Levitation-Texas-Guadaloop/Lev-Main/misc/Diagram_1.png

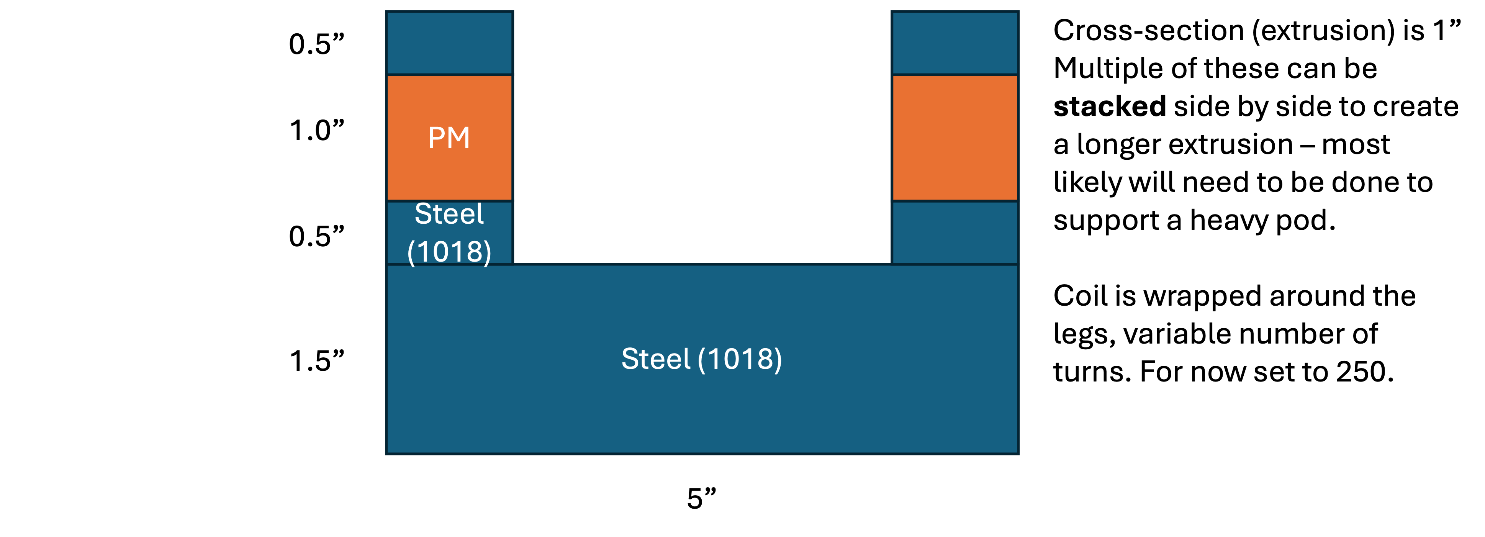
misc/Diagram_1.png
