Levitation-Texas-Guadaloop/Lev-Main/SCS_Laminations/preview.png

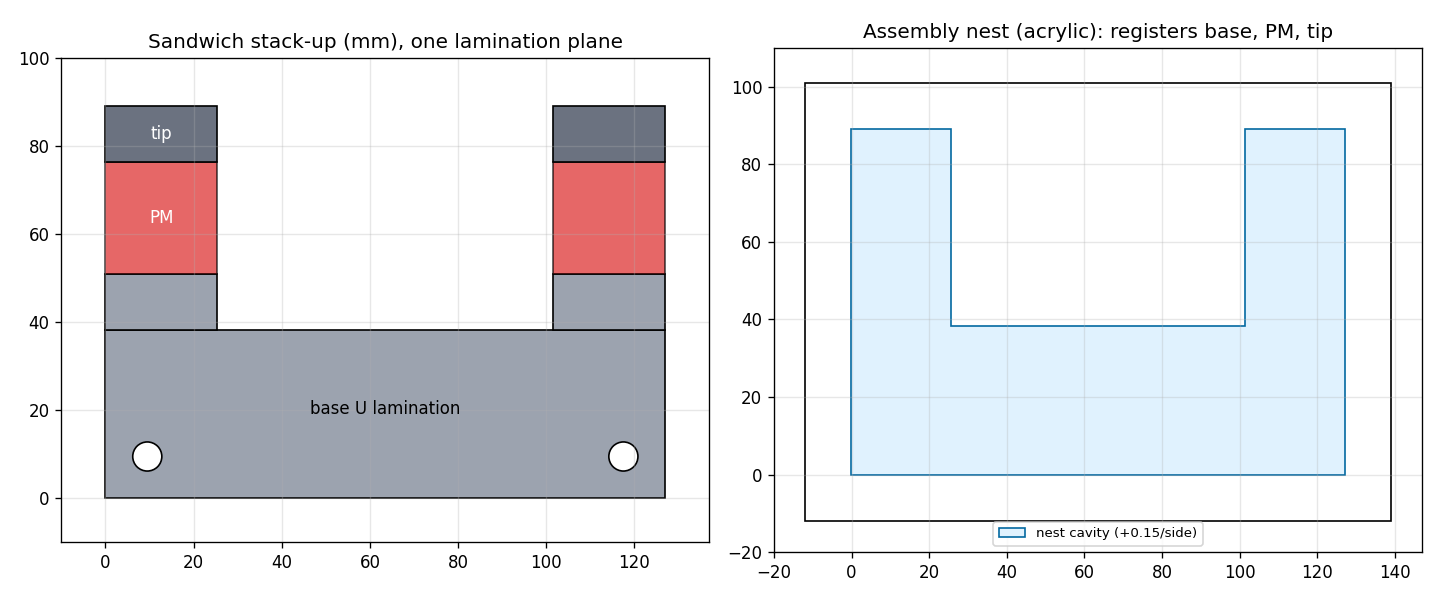
SCS_Laminations/preview.png
