Levitation-Texas-Guadaloop/Lev-Main/tutorials/bode_poles/fig1_bode_good_design.png

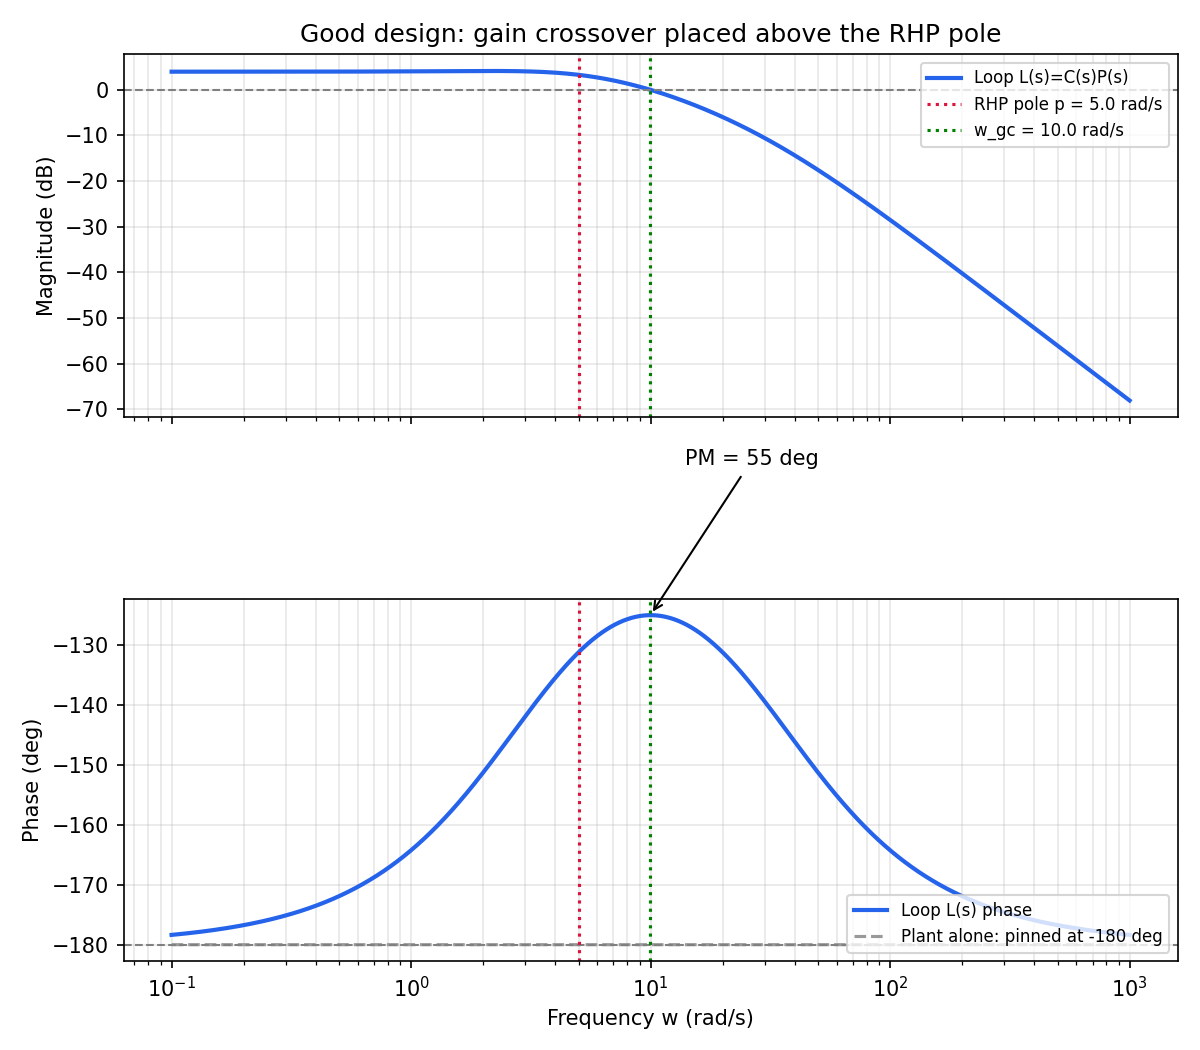
tutorials/bode_poles/fig1_bode_good_design.png
