Levitation-Texas-Guadaloop/Lev-Main/SCS_Lamination_CrossSection.FCStd

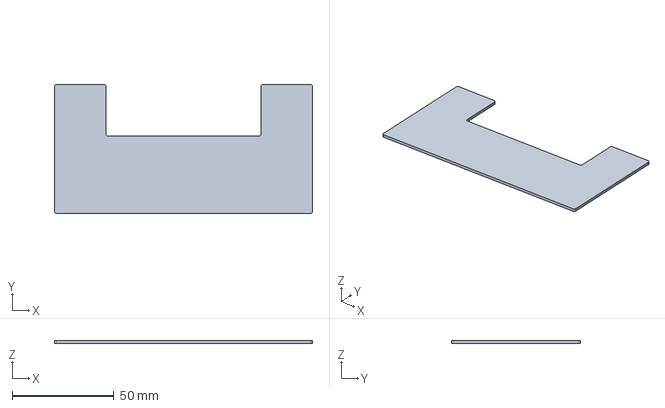
[picture p4: CAD file, 2026-09-30]
SCS_Lamination_CrossSection.FCStd
127.0 x 63.5 x 1.50 mm
