Levitation-Texas-Guadaloop/Lev-Main/SCS_Laminations/SCS_Lamination_CrossSection-Body.step

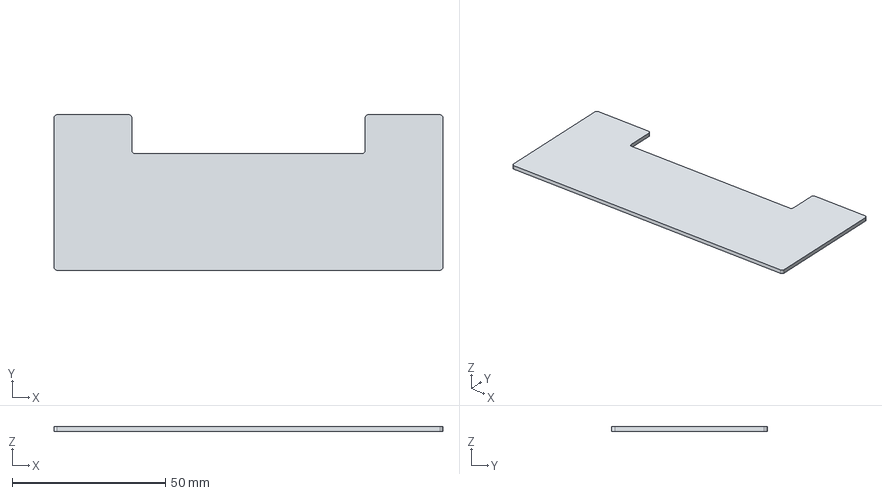
[picture p6: CAD file, 2026-10-15]
SCS_Laminations/SCS_Lamination_CrossSection-Body.step
127.0 x 50.8 x 1.50 mm
