Levitation-Texas-Guadaloop/Lev-Main/SCS_Laminations/pole_tip_lamination.dxf

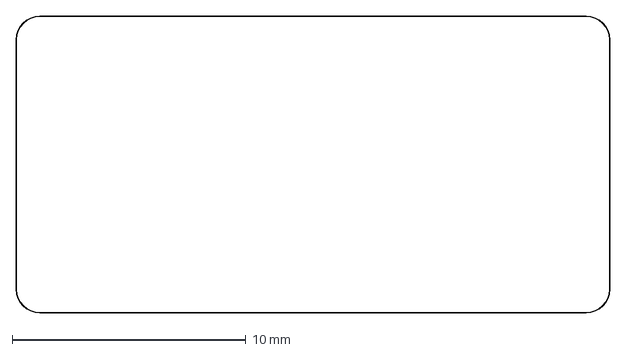
[picture p7: CAD file, 2026-10-15]
SCS_Laminations/pole_tip_lamination.dxf
25.4 x 12.7 mm
