Levitation-Texas-Guadaloop/Lev-Main/SCS_Laminations/jig_nest_bottom.dxf

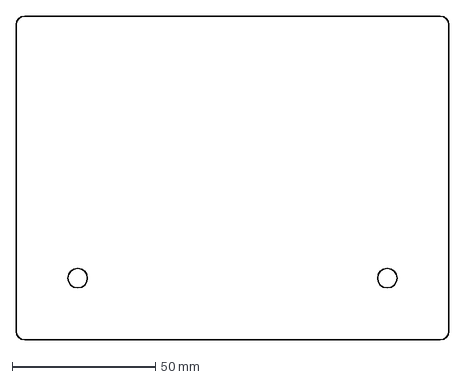
[picture p8: CAD file, 2026-10-15]
SCS_Laminations/jig_nest_bottom.dxf
151.0 x 112.9 mm
