Levitation-Texas-Guadaloop/Lev-Main/SCS_Laminations/jig_tip_bottom.dxf

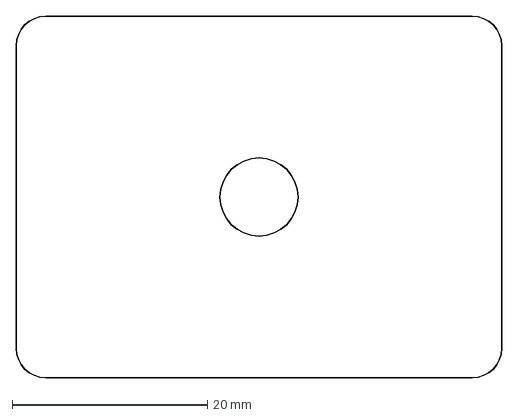
[picture p9: CAD file, 2026-10-15]
SCS_Laminations/jig_tip_bottom.dxf
49.7 x 37.0 mm
