Levitation-Texas-Guadaloop/Lev-Main/SCS_Laminations/jig_nest_cavity.dxf

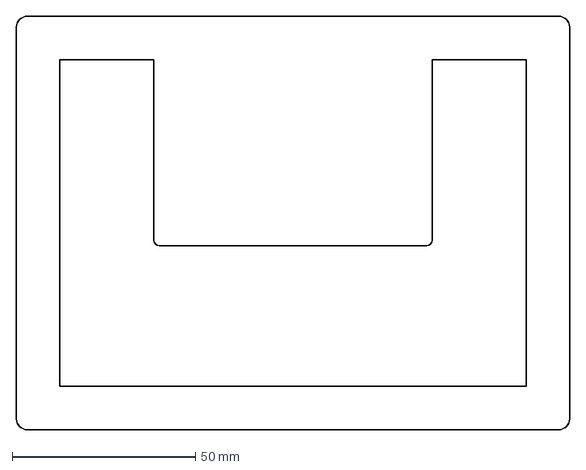
[picture p10: CAD file, 2026-10-15]
SCS_Laminations/jig_nest_cavity.dxf
151.0 x 112.9 mm
