Levitation-Texas-Guadaloop/Lev-Main/(list of files, cad)

Other CAD files:
SCS_Lamination_CrossSection_STP.step
SCS_Laminations/SCS_Lamination_CrossSection.FCStd
