Levitation-Texas-Guadaloop/Lev-Main/tutorials/bode_poles/fig0_bode_plant_only.png

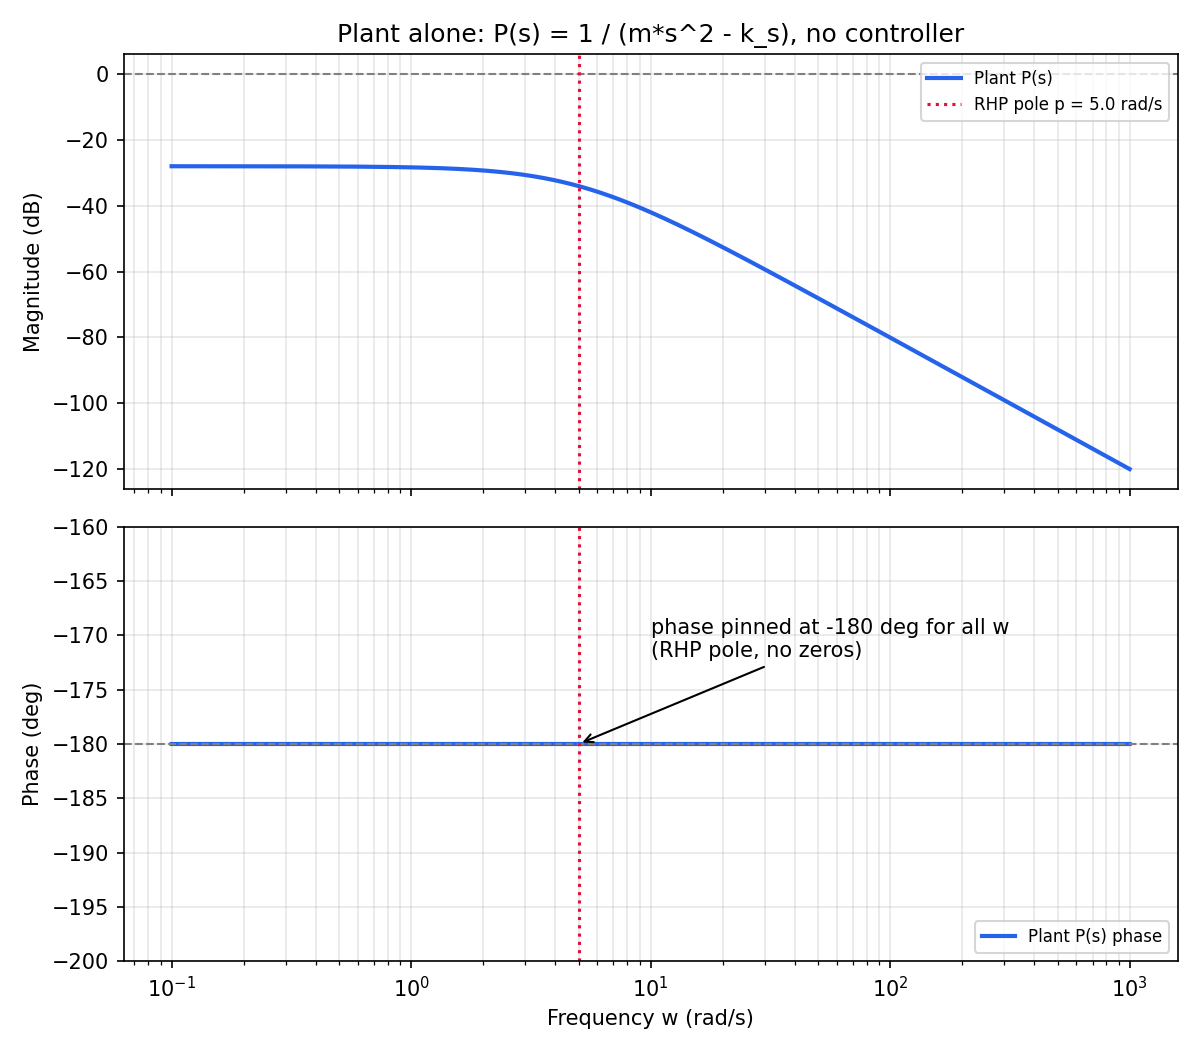
tutorials/bode_poles/fig0_bode_plant_only.png
