Levitation-Texas-Guadaloop/Lev-Main/tutorials/bode_poles/fig2_good_vs_bad_polezero.png

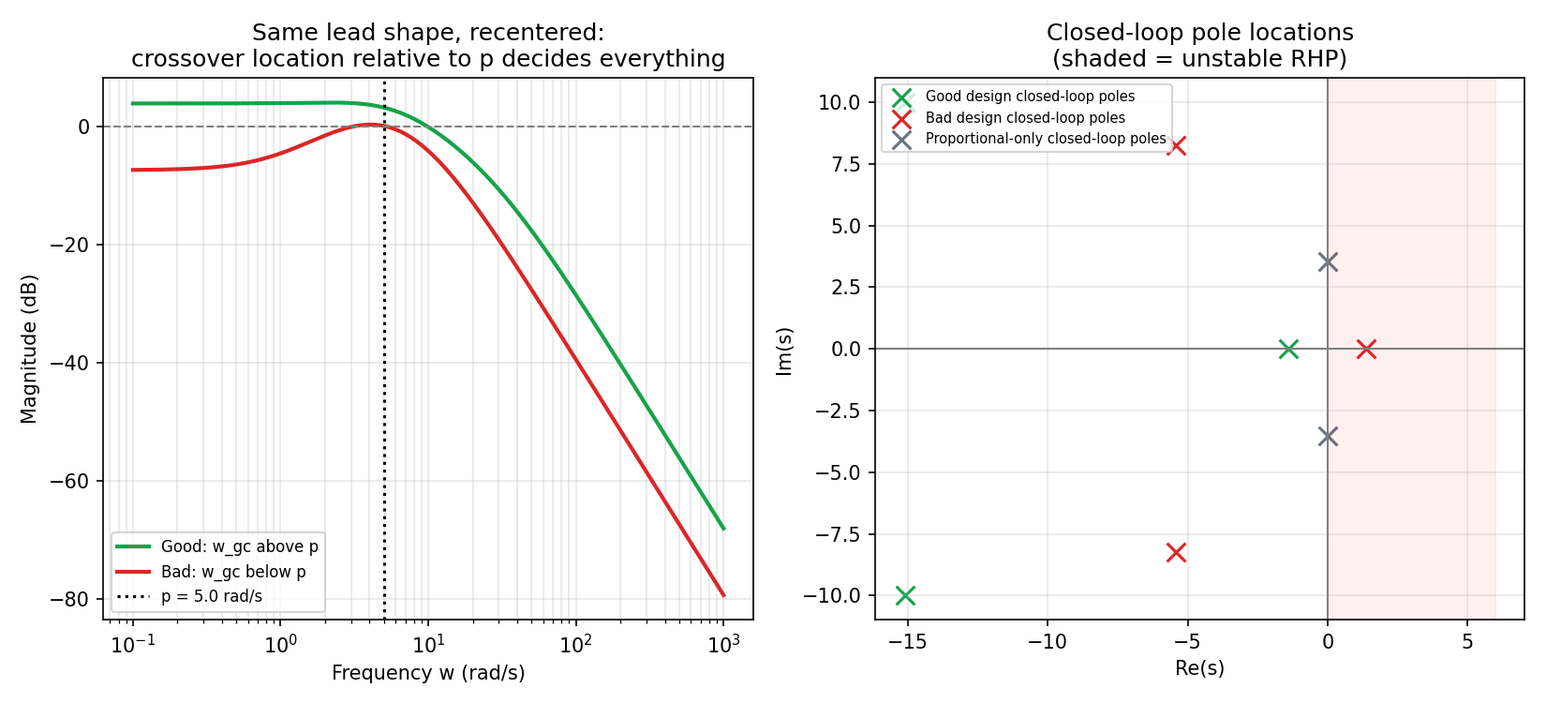
tutorials/bode_poles/fig2_good_vs_bad_polezero.png
