Levitation-Texas-Guadaloop/Lev-Main/tutorials/bode_poles/fig3_sensitivity_waterbed.png

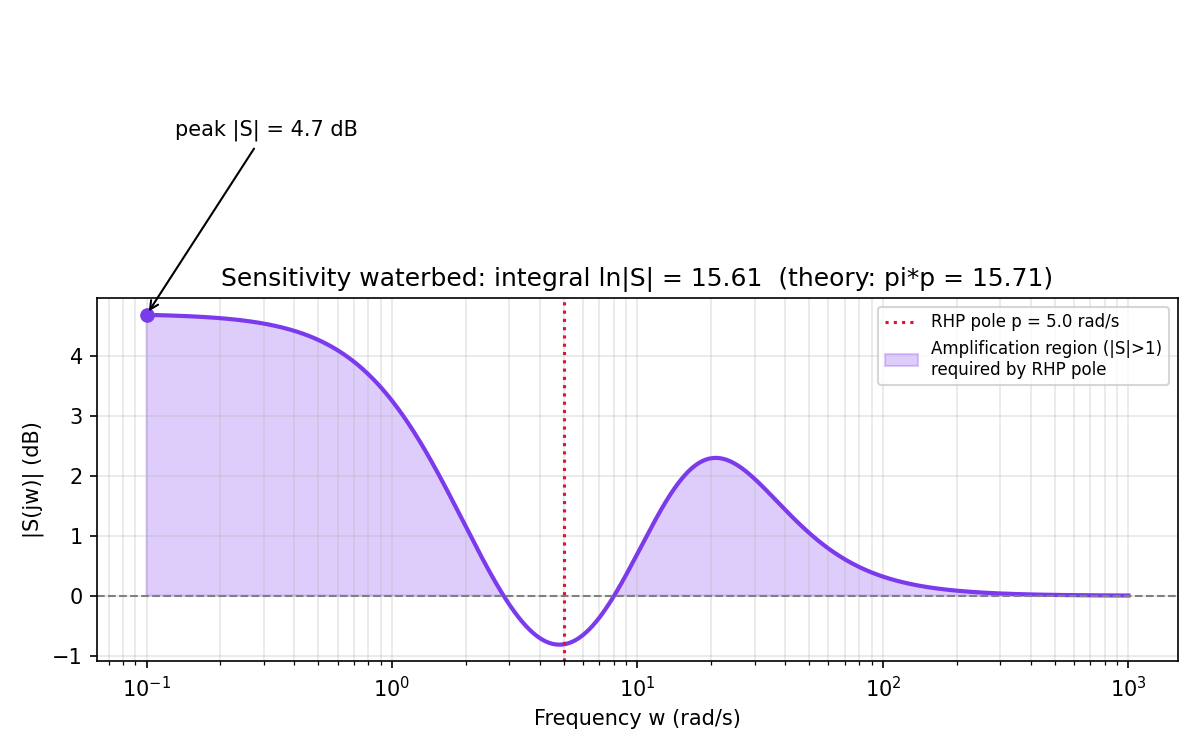
tutorials/bode_poles/fig3_sensitivity_waterbed.png
