Levitation-Texas-Guadaloop/Lev-Main/tutorials/figures/eddy_margins.png

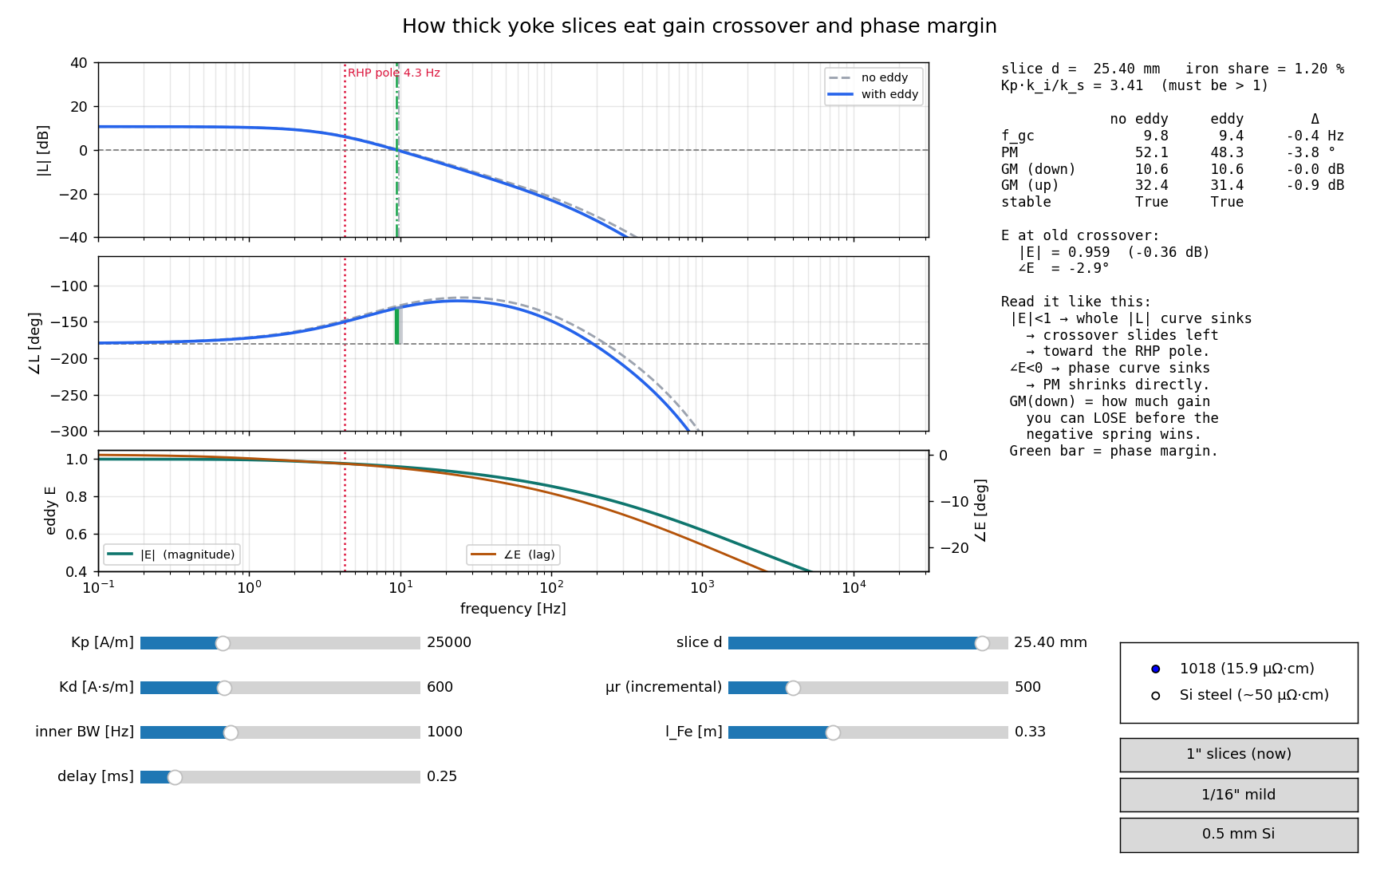
tutorials/figures/eddy_margins.png
