Levitation-Texas-Guadaloop/Lev-Main/tutorials/figures/inductance_vs_gap.png

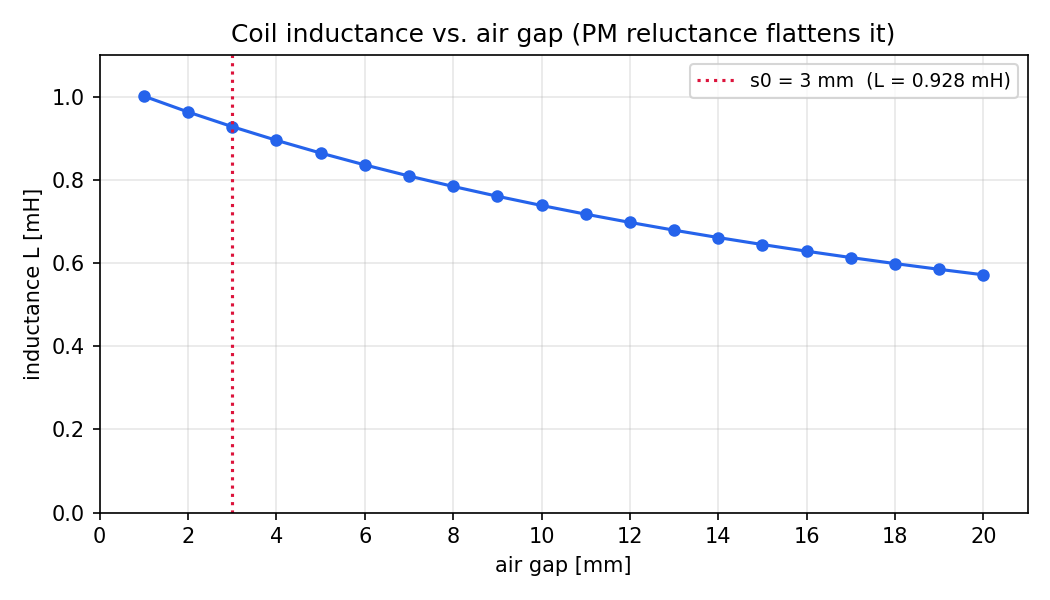
tutorials/figures/inductance_vs_gap.png
