Levitation-Texas-Guadaloop/Lev-Main/tutorials/figures/layer1_openloop.png

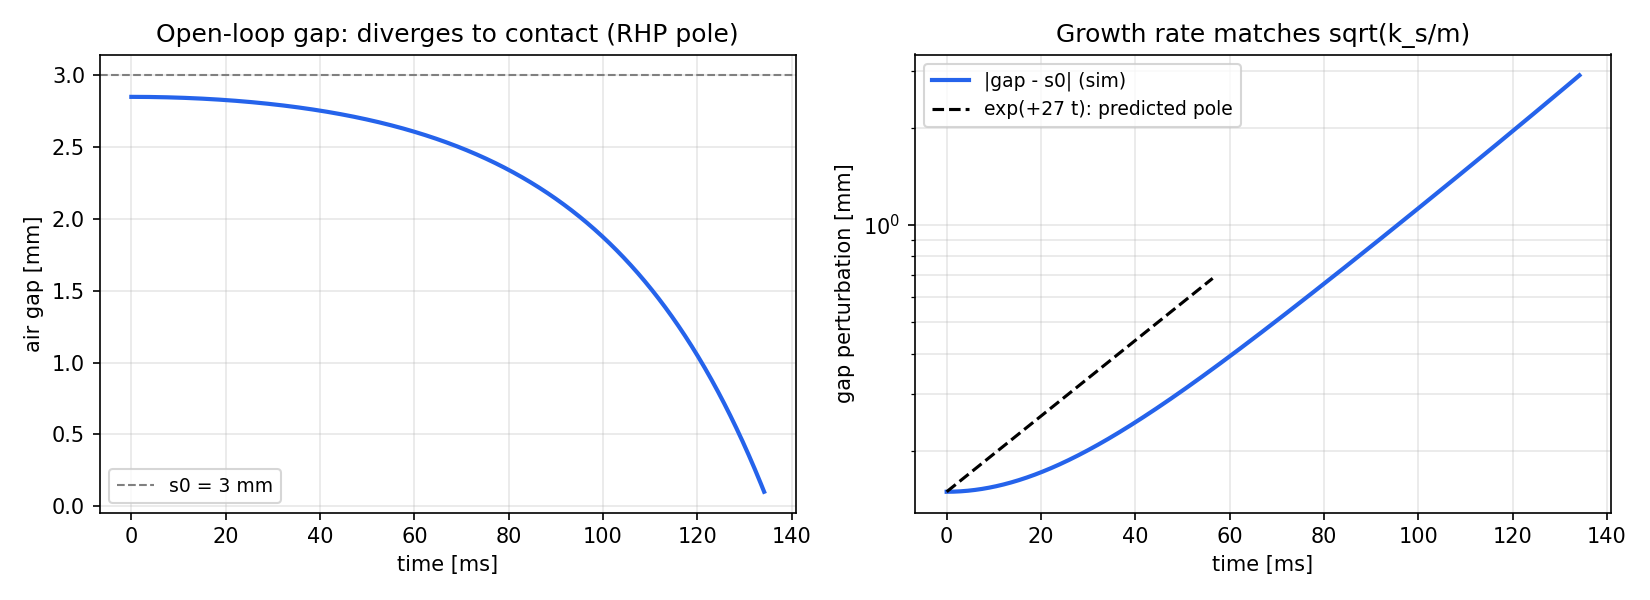
tutorials/figures/layer1_openloop.png
