Levitation-Texas-Guadaloop/Lev-Main/tutorials/figures/layer2_current_loop.png

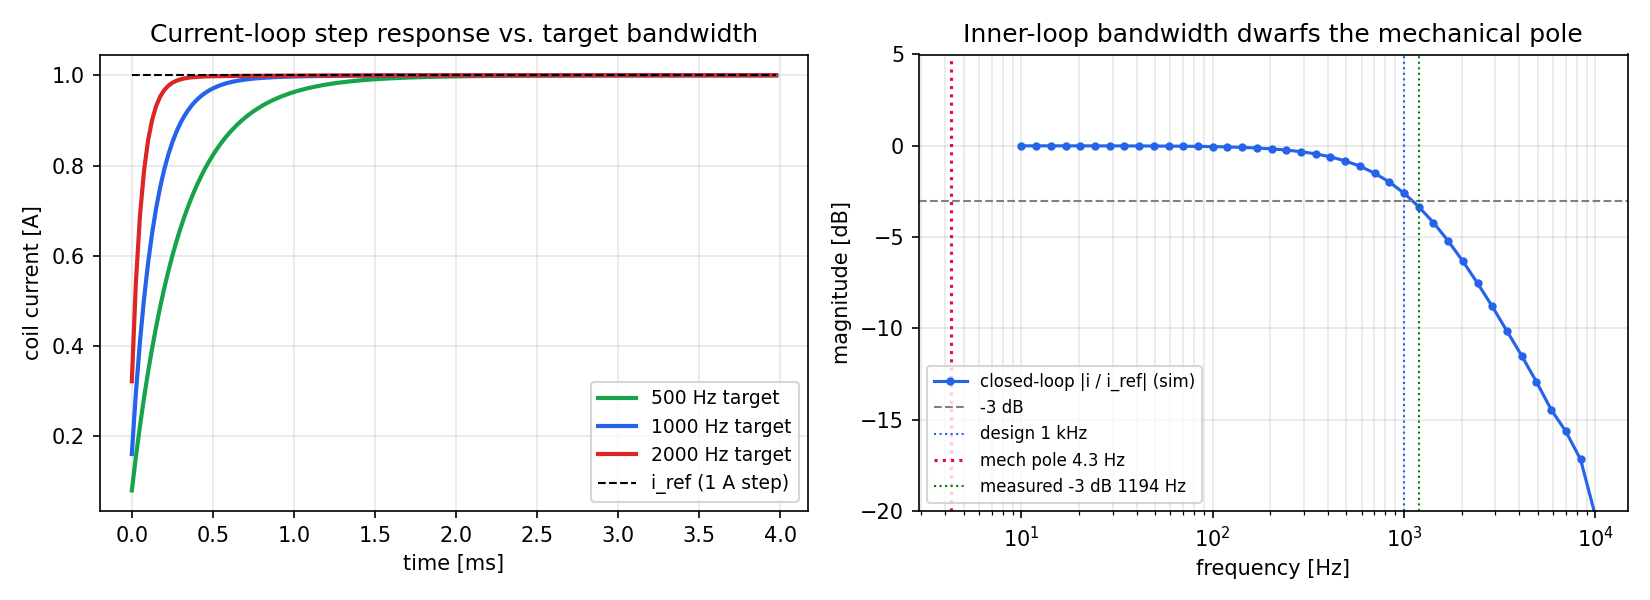
tutorials/figures/layer2_current_loop.png
