Levitation-Texas-Guadaloop/Lev-Main/tutorials/figures/layer3_bode.png

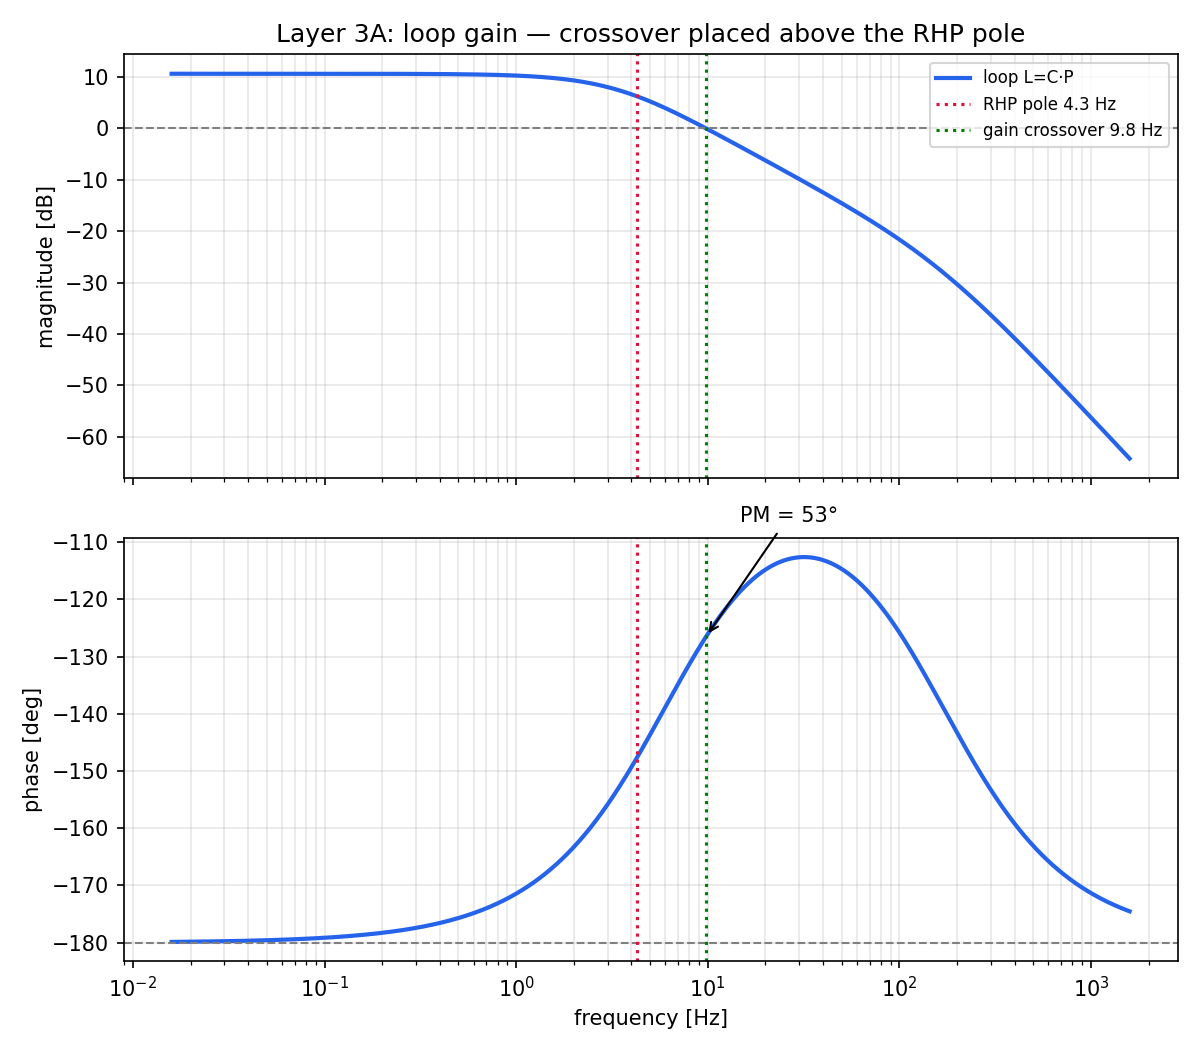
tutorials/figures/layer3_bode.png
