Levitation-Texas-Guadaloop/Lev-Main/tutorials/figures/layer3_nonlinear.png

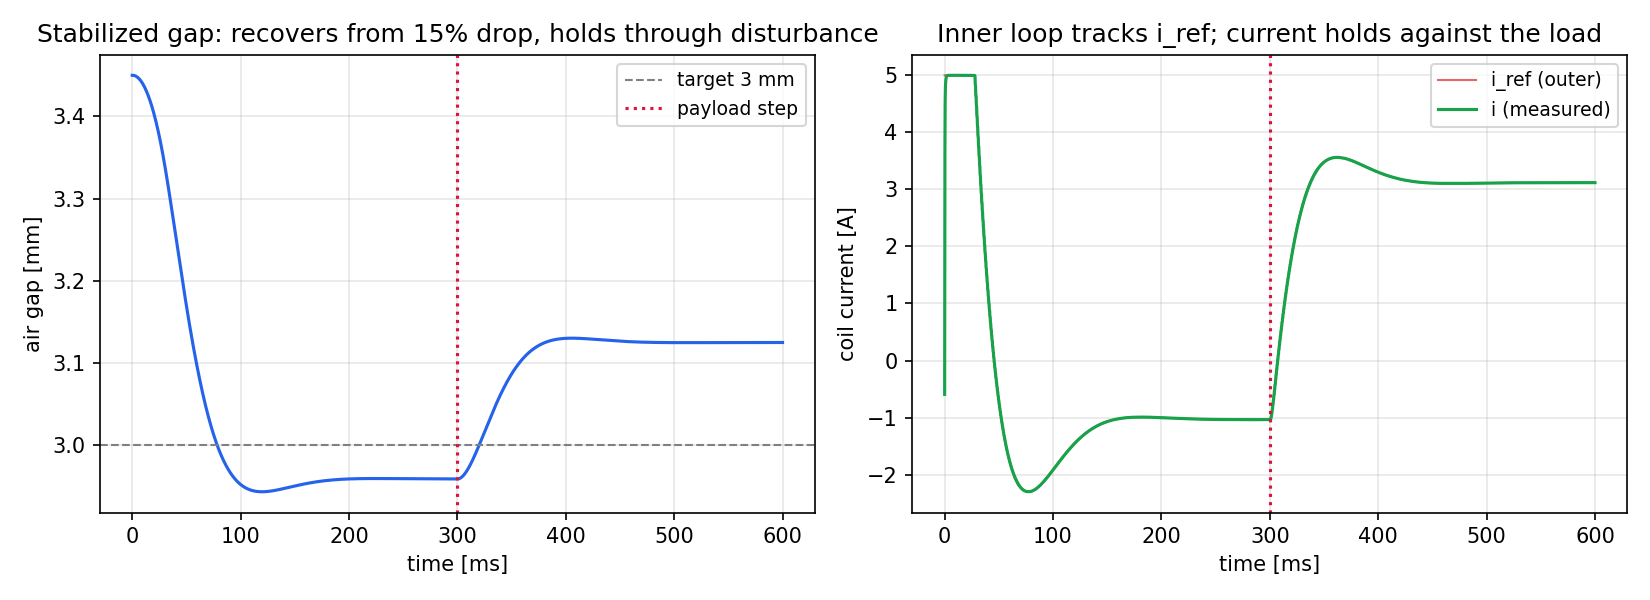
tutorials/figures/layer3_nonlinear.png
