Levitation-Texas-Guadaloop/Lev-Main/tutorials/figures/layer4_lqr.png

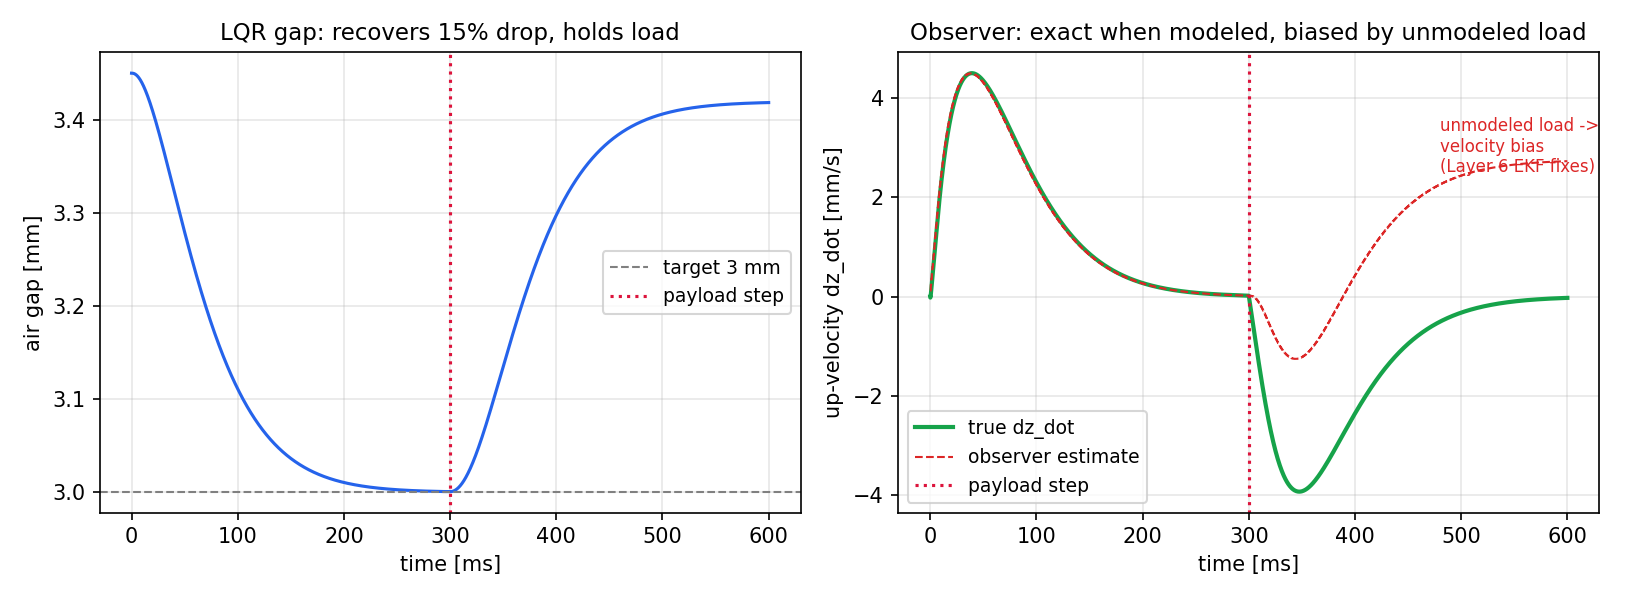
tutorials/figures/layer4_lqr.png
