Levitation-Texas-Guadaloop/Lev-Main/tutorials/figures/pid_tuner_preview.png

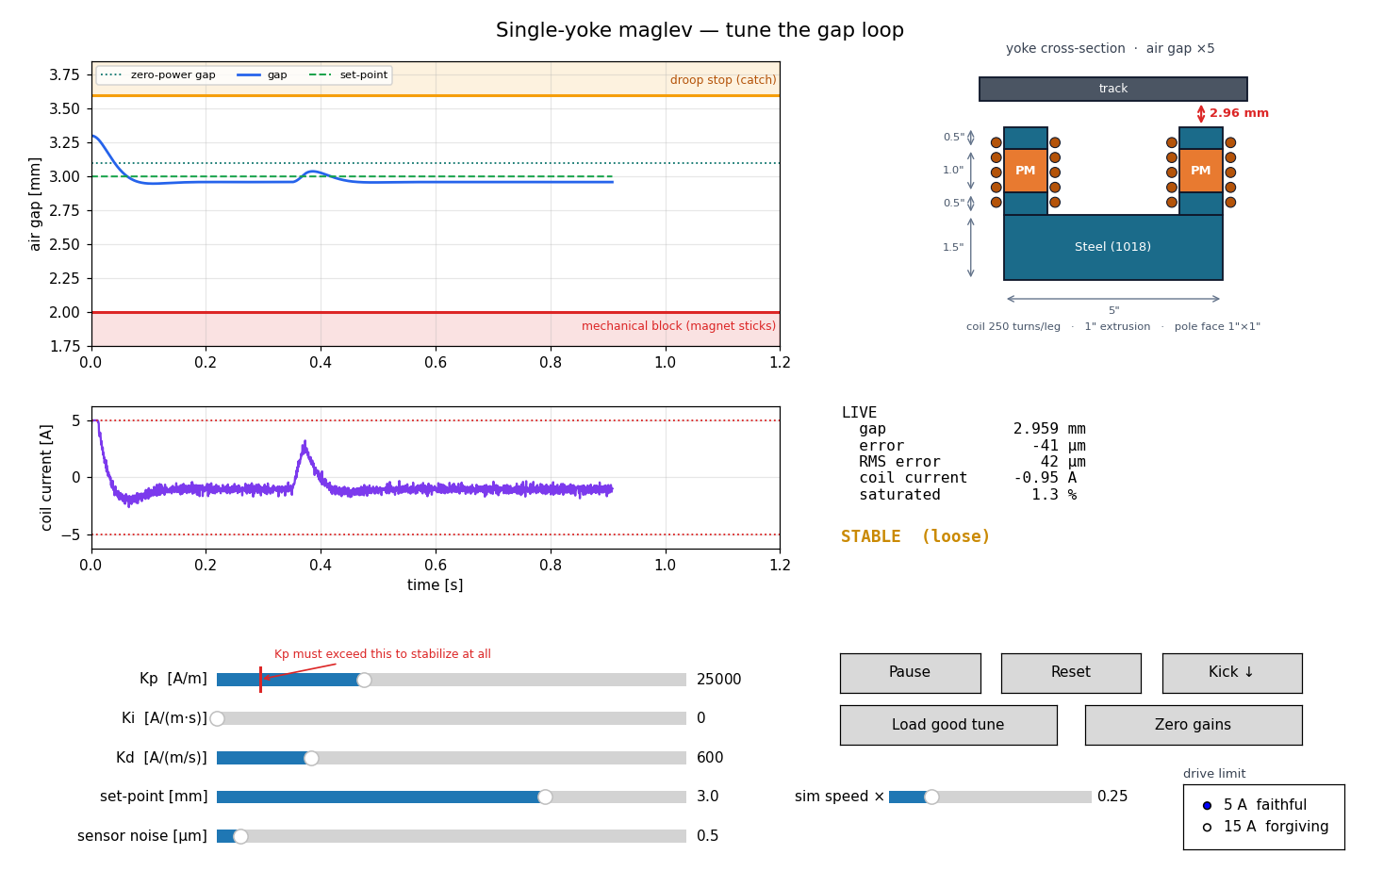
tutorials/figures/pid_tuner_preview.png
