Levitation-Texas-Guadaloop/Lev-Main/(commit log)

2026-09-19 Reorganize RFCs into streams/knowledge; add S6 stub and tutorials
    Split docs/rfcs into two directories reflecting how the docs are used:
    - streams/ master docs with an owner and a Linear milestone
    - knowledge/ reference and rationale; no owner, no stream
    Wikilinks resolve by filename, so the moves break no [[links]].
    Also:
    - New S6 master doc (Magnet Manufacture and Shielding) — stub, scoping only
    - Track tutorials/ (staged maglev sim package, layer scripts, PID tuner demo)
    - Add .gitignore for .DS_Store, __pycache__, .venv
    All 15 RFCs are now mirrored as Linear Documents and linked from their
    milestones. The markdown here stays the clean copy of the LaTeX, which
    Linear's renderer m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
2026-09-22 draft first pass of magnetic circuit model visualizer and reluctance model
2026-09-30 directory reorg, magnetic circuit model, lamination prototype
    [SCS_Lamination_CrossSection.FCStd, SCS_Lamination_CrossSection_STP.step]
2026-10-10 rename and track lalmination docs
2026-10-15 power calcs, coil resistance fit, web interface for magnetic circuit model
2026-10-15 lamination dxf/cad
